carlosgj/Garage-Controller/MCAD/7527K44_300V AC-300V DC Terminal Block.SLDPRT

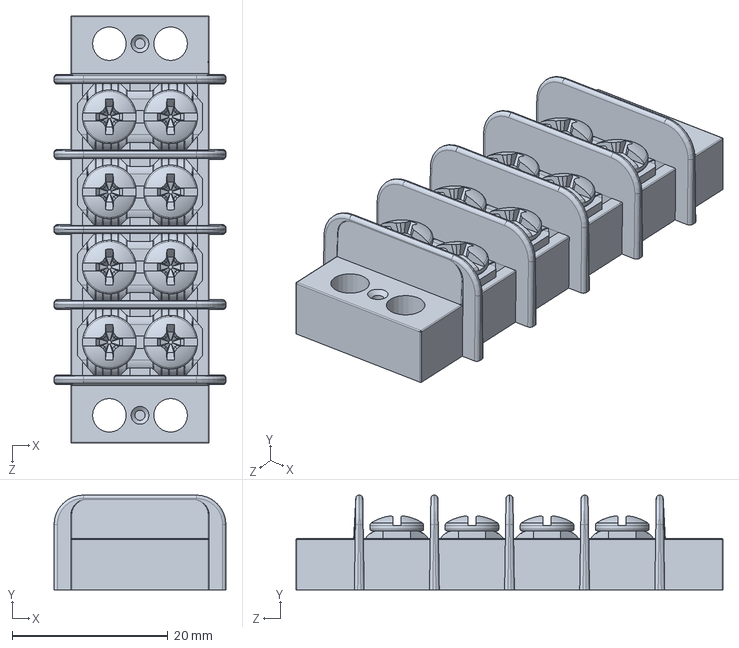
[picture p1: CAD file, 2026-06-23]
MCAD/7527K44_300V AC-300V DC Terminal Block.SLDPRT
22.1 x 12.2 x 54.9 mm
