carlosgj/Garage-Controller/MCAD/Controller.SLDASM

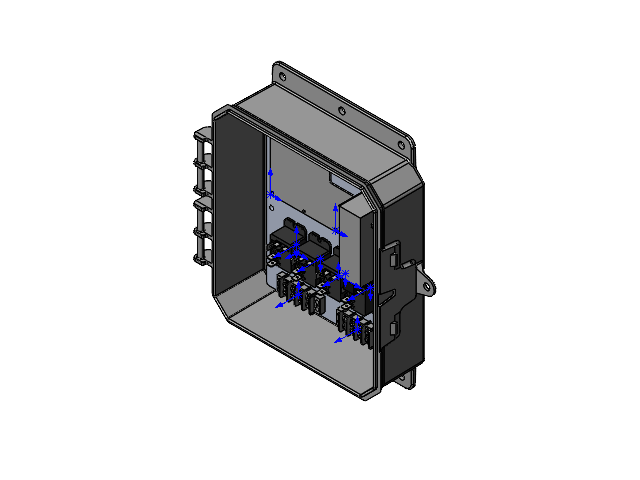
[picture p2: CAD file, 2026-06-27]
MCAD/Controller.SLDASM
Baseplate
J115F3E1CL x 4
7527K44_300V AC-300V DC Terminal Block x 2
converter_rs-25-12
PWB
P982BH
