carlosgj/Garage-Controller/MCAD/Electronics Assembly.SLDASM

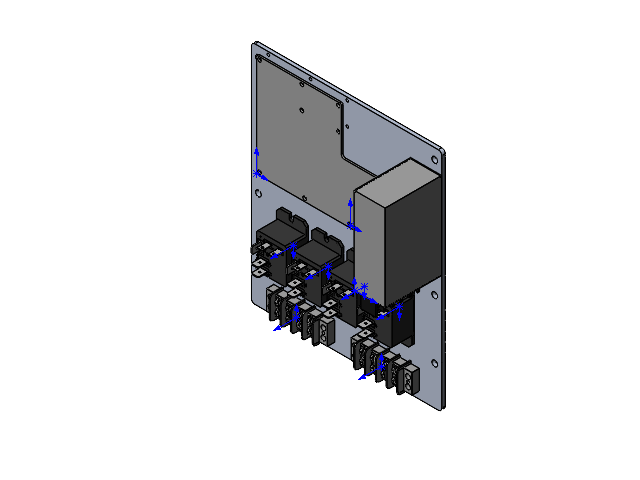
[picture p3: CAD file, 2026-06-27]
MCAD/Electronics Assembly.SLDASM
Baseplate
J115F3E1CL x 4
7527K44_300V AC-300V DC Terminal Block x 2
converter_rs-25-12
PWB
