carlosgj/Garage-Controller/MCAD/p9082.SLDASM

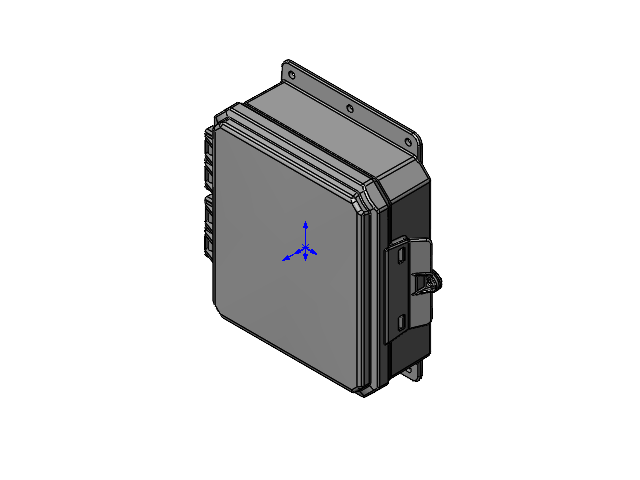
[picture p4: CAD file, 2026-06-23]
MCAD/p9082.SLDASM
P982BH
P98CHO
