carlosgj/Garage-Controller/(list of files, cad)

Other CAD files:
MCAD/Baseplate.SLDPRT
MCAD/PWB.SLDPRT
MCAD/converter_rs-25-12.SLDPRT
MCAD/J115F3E1CL.SLDPRT
MCAD/P98CHO.SLDPRT
MCAD/P982BH.SLDPRT
