carlosgj/Garage-Controller/ECAD/Sensor Board.brd

## EAGLE design ECAD/Sensor Board.brd (2026-07-01)

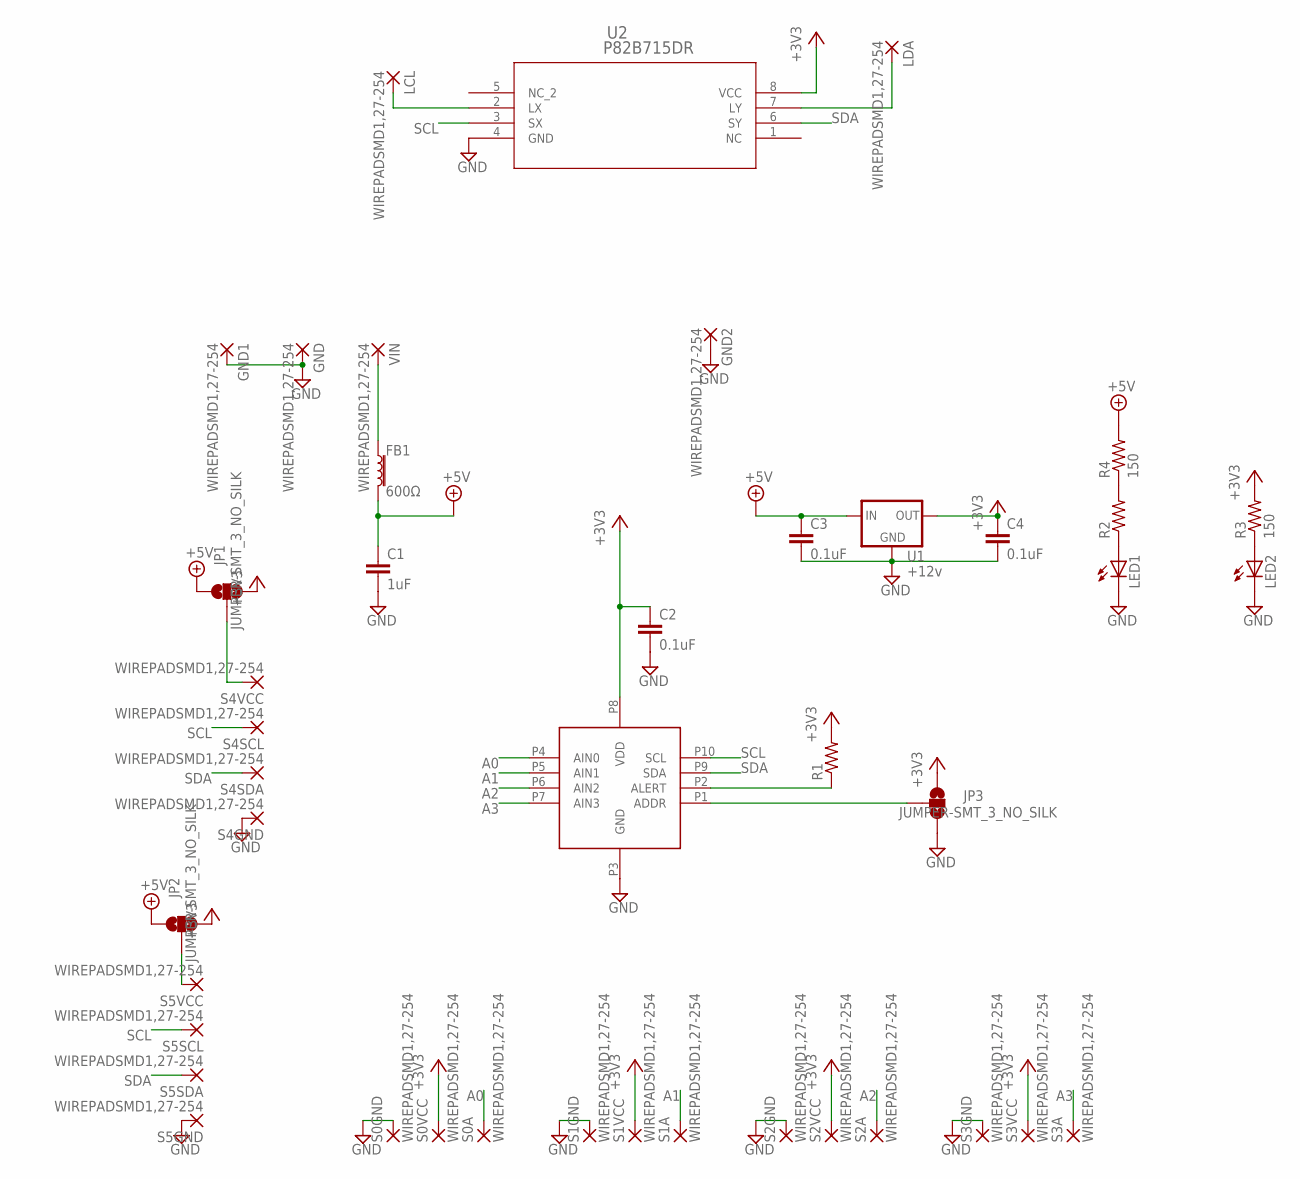
[picture p5: schematic Sensor Board.sch]

Parts:
C1: 1uF; C0805
C2, C3, C4: 0.1uF; C0805
FB1: 600Ω; 0805
GND, GND1, GND2: WIREPADSMD1,27-254; SMD1,27-2,54
JP1, JP2, JP3: JUMPER-SMT_3_NO_SILK; SMT-JUMPER_3_NO_SILK
LCL: WIREPADSMD1,27-254; SMD1,27-2,54
LDA: WIREPADSMD1,27-254; SMD1,27-2,54
LED1, LED2: LEDCHIP-LED0805; CHIP-LED0805
R1, R2: R-US_R0805; R0805
R3, R4: 150; R0805
S0A, S0GND, S0VCC, S1A, S1GND, S1VCC, S2A, S2GND, S2VCC, S3A, S3GND, S3VCC, S4GND, S4SCL, S4SDA, S4VCC, S5GND, S5SCL, S5SDA, S5VCC: WIREPADSMD1,27-254; SMD1,27-2,54
U1: +12v; TO-252
U2: P82B715DR; SO-08
U3: ADS1115; VSSOP-10
VIN: WIREPADSMD1,27-254; SMD1,27-2,54

Connections:
+3V3: C2.1, C4.1, JP1.3, JP2.3, JP3.1, R1.2, R3.2, S0VCC.1, S1VCC.1, S2VCC.1, S3VCC.1, U1.2 (OUT), U2.8 (VCC), U3.P8 (VDD)
+5V: C1.1, C3.1, FB1.2, JP1.1, JP2.1, R4.2, U1.1 (IN)
A0: S0A.1, U3.P4 (AIN0)
A1: S1A.1, U3.P5 (AIN1)
A2: S2A.1, U3.P6 (AIN2)
A3: S3A.1, U3.P7 (AIN3)
GND: C1.2, C2.2, C3.2, C4.2, GND.1, GND1.1, GND2.1, JP3.3, LED1.C, LED2.C, S0GND.1, S1GND.1, S2GND.1, S3GND.1, S4GND.1, S5GND.1, U1.3 (GND), U2.4 (GND), U3.P3 (GND)
unnamed: R1.1, U3.P2 (ALERT)
unnamed: FB1.1, VIN.1
unnamed: JP2.2, S5VCC.1
unnamed: JP3.2, U3.P1 (ADDR)
unnamed: JP1.2, S4VCC.1
unnamed: LED1.A, R2.1
unnamed: LED2.A, R3.1
unnamed: R2.2, R4.1
unnamed: LDA.1, U2.7 (LY)
unnamed: LCL.1, U2.2 (LX)
SCL: S4SCL.1, S5SCL.1, U2.3 (SX), U3.P10 (SCL)
SDA: S4SDA.1, S5SDA.1, U2.6 (SY), U3.P9 (SDA)

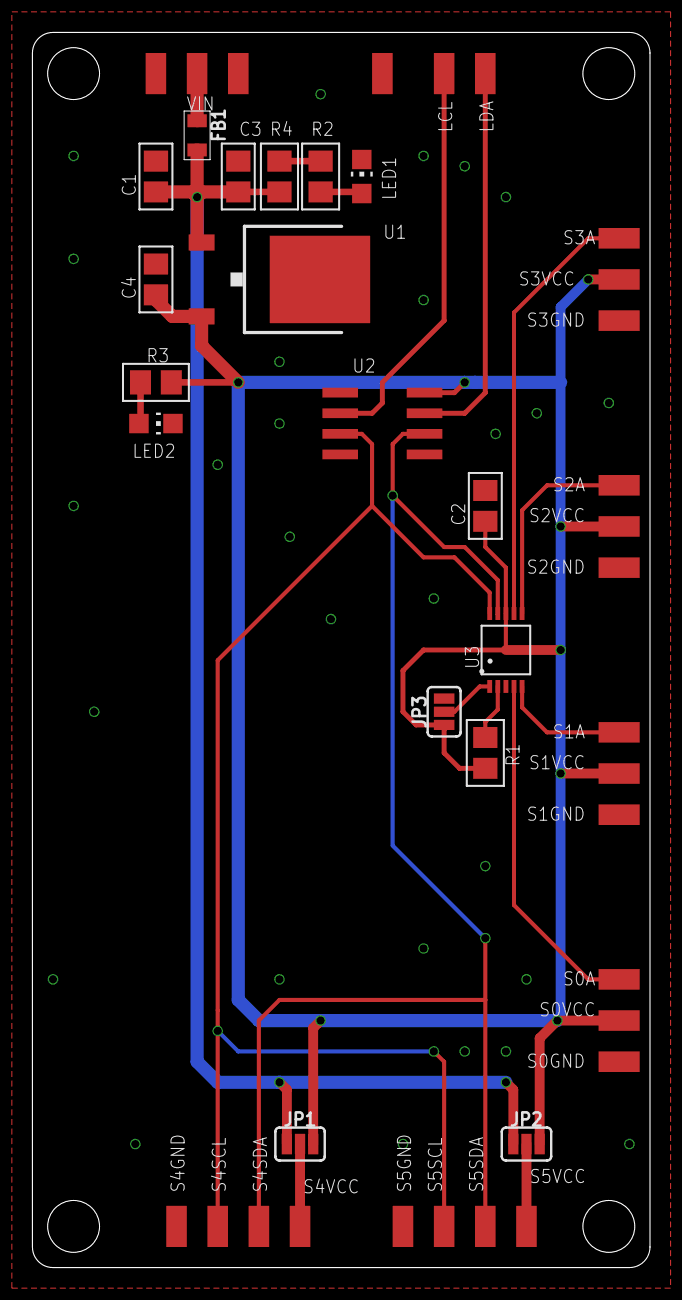
[picture p6: board Sensor Board.brd from above]

Board: 2 copper layers, 38.1 x 76.2 mm, 43 parts (0 on the bottom side), 19 nets.
