carlosgj/Garage-Controller/ECAD/Garage_Controller.brd

## EAGLE design ECAD/Garage_Controller.brd (2026-07-01)

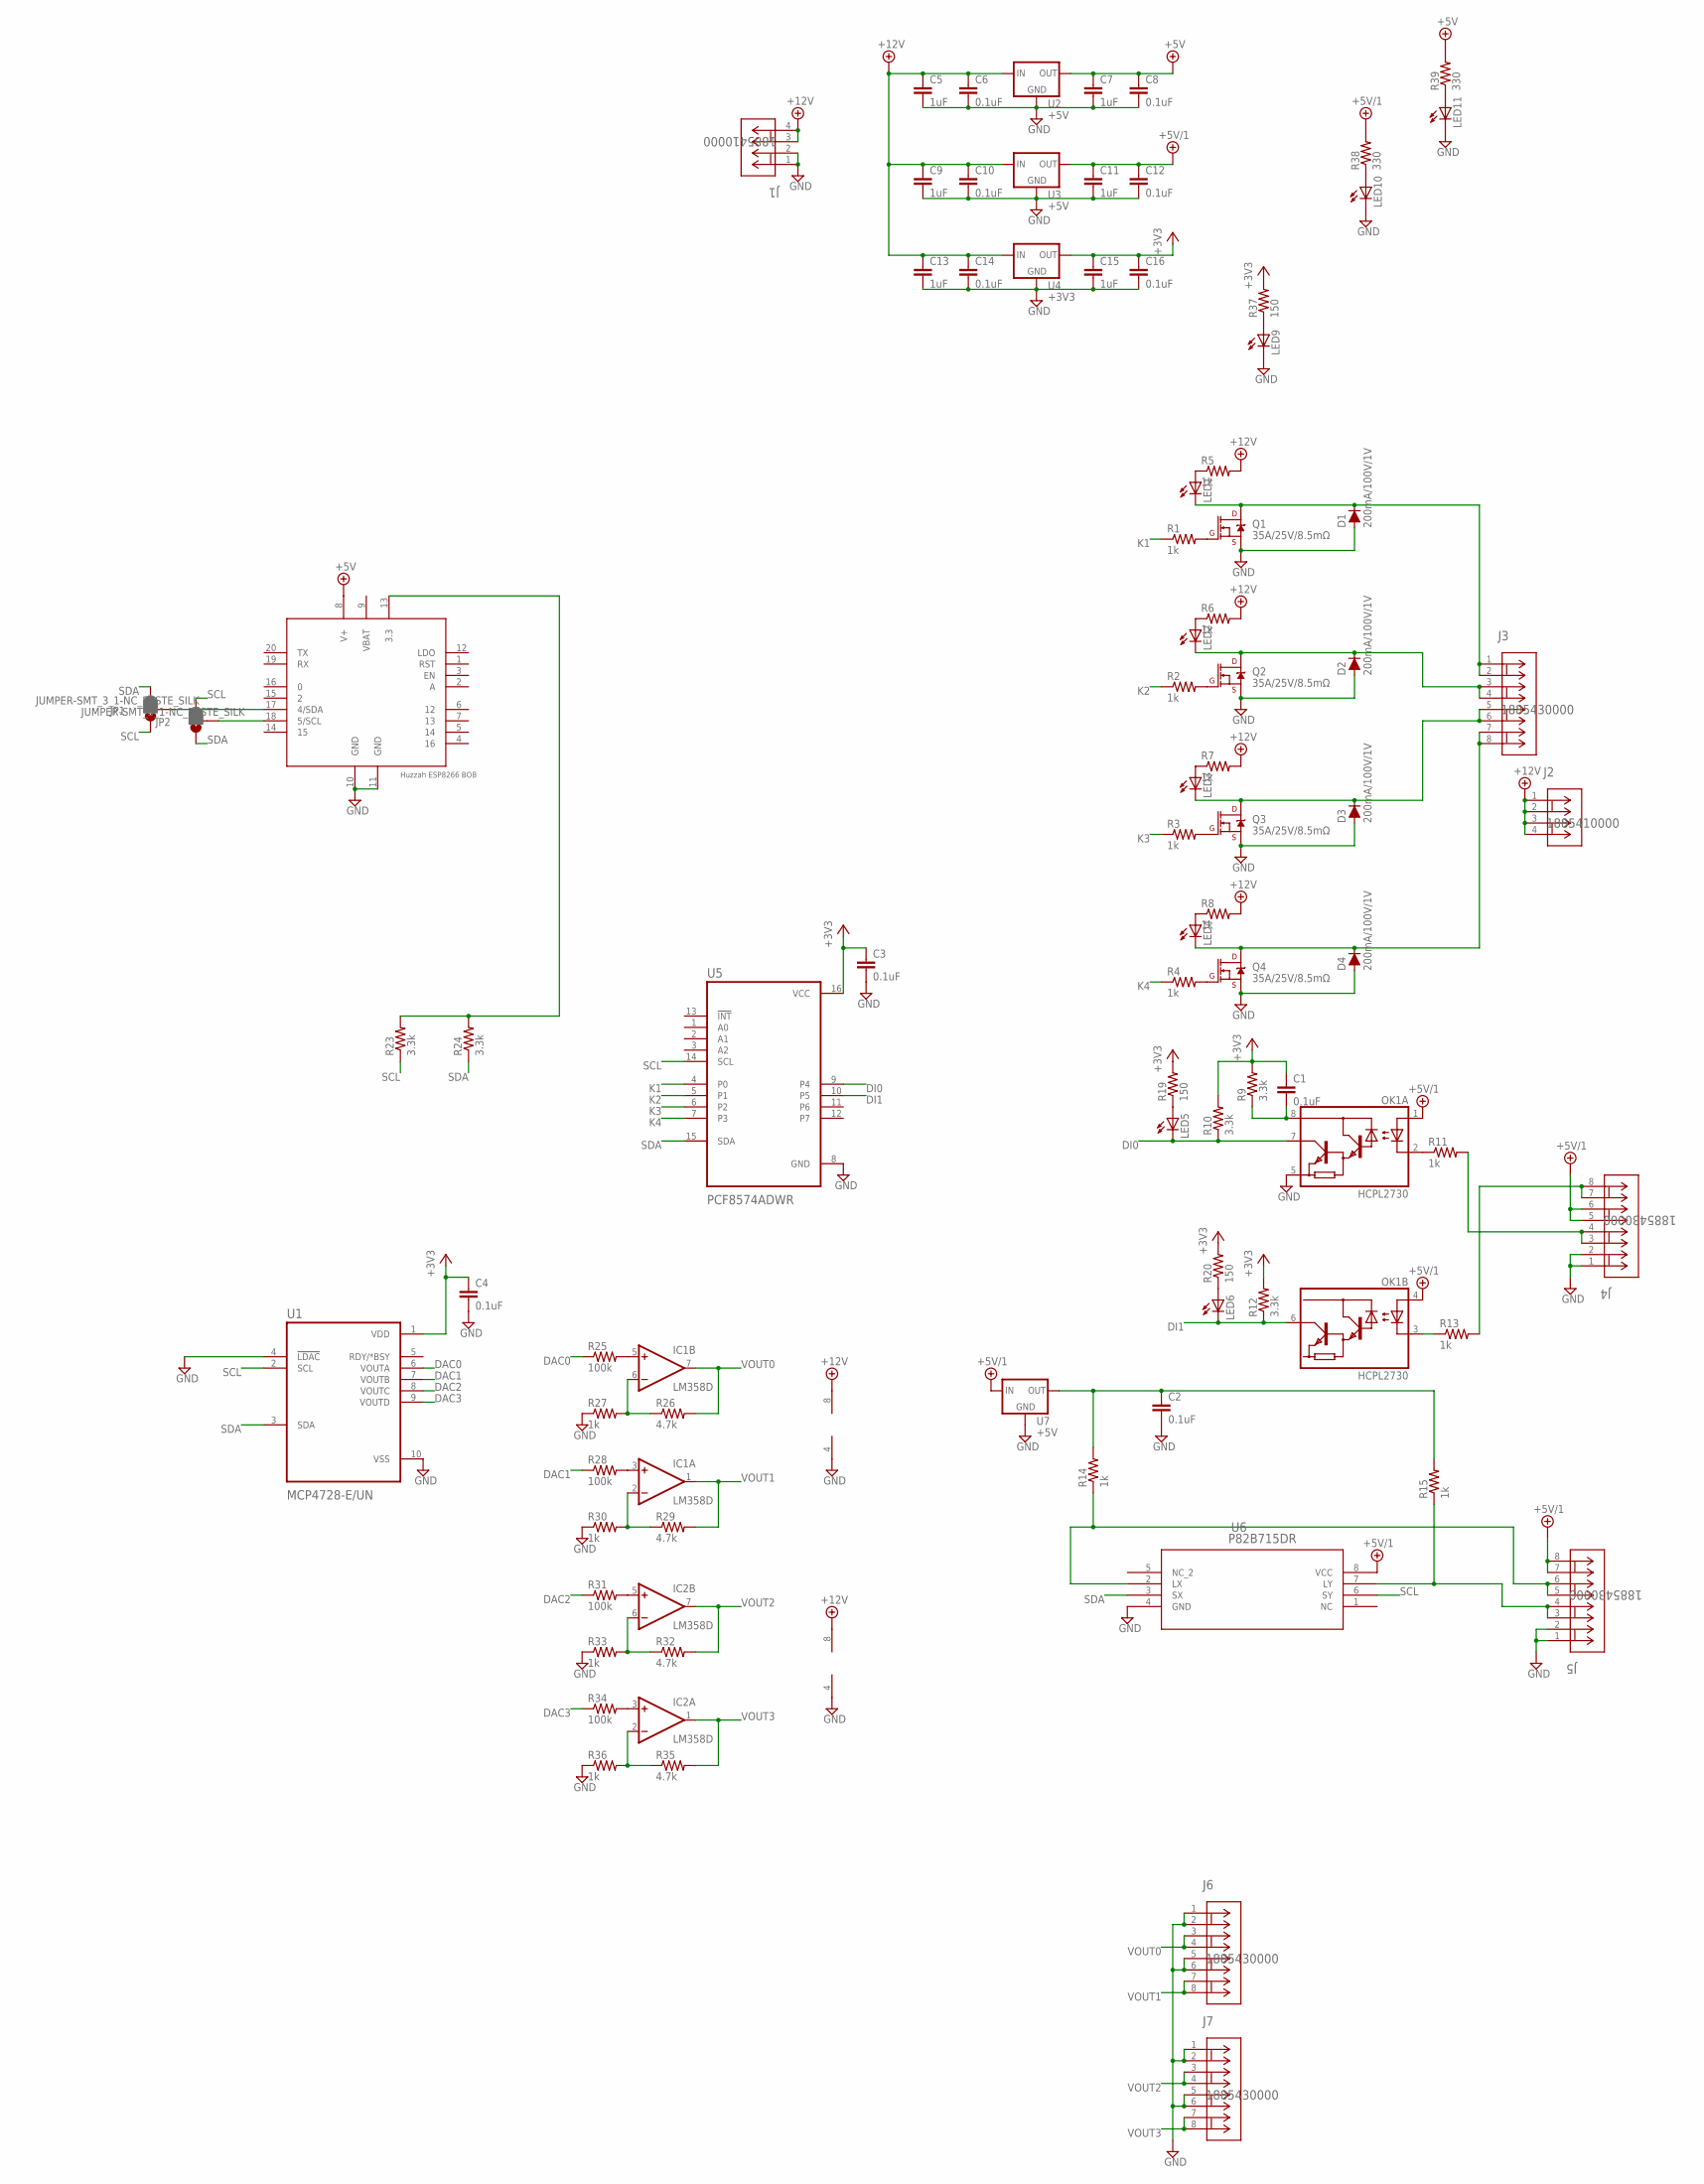
[picture p7: schematic Garage_Controller.sch]

Parts:
C1, C2, C3, C4, C6, C8, C10, C12, C14, C16: 0.1uF; C0805
C5, C7, C9, C11, C13, C15: 1uF; C0805
D1, D2, D3, D4: 200mA/100V/1V; DIODE-1N4148
IC1, IC2: LM358D; SO08
J1, J2: 1885410000; CONN_1885410000_WED
J3, J4, J5, J6, J7: 1885430000; CONN_1885430000_WED
JP1, JP2: JUMPER-SMT_3_1-NC_PASTE_SILK; SMT-JUMPER_3_1-NC_PASTE_SILK
LED1, LED2, LED3, LED4, LED5, LED6, LED9, LED10, LED11: LEDCHIP-LED0805; CHIP-LED0805
OK1: HCPL2730; DIL08
Q1, Q2, Q3, Q4: 35A/25V/8.5mΩ; TO-252/DPAK
R1, R2, R3, R4, R5, R6, R7, R8, R11, R13, R14, R15, R27, R30, R33, R36: 1k; R0805
R9, R10, R12, R23, R24: 3.3k; R0805
R19, R20, R37: 150; R0805
R25, R28, R31, R34: 100k; R0805
R26, R29, R32, R35: 4.7k; R0805
R38, R39: 330; R0805
U1: MCP4728-E/UN; SOP50P490X110-10N
U2, U3, U7: +5V; TO-252
U4: +3V3; TO-252
U5: PCF8574ADWR; SOIC127P1030X265-16N
U6: P82B715DR; SO-08
U$2: HUZZAH_ESP8266_BREAKOUT

Connections:
+3V3: C1.1, C3.1, C4.1, C15.1, C16.1, R9.2, R10.2, R12.2, R19.2, R20.2, R37.2, U1.1 (VDD), U4.2 (OUT), U5.16 (VCC)
+5V: C7.1, C8.1, R39.2, U2.2 (OUT), U$2.8 (V+)
+5V/1: C11.1, C12.1, J4.5, J4.6, J5.7, J5.8, OK1.1 (A1), OK1.4 (A2), R38.2, U3.2 (OUT), U6.8 (VCC), U7.1 (IN)
+12V: C5.1, C6.1, C9.1, C10.1, C13.1, C14.1, IC1.8 (V+), IC2.8 (V+), J1.3, J1.4, J2.1, J2.2, J2.3, J2.4, R5.2, R6.2, R7.2, R8.2, U2.1 (IN), U3.1 (IN), U4.1 (IN)
DAC0: R25.1, U1.6 (VOUTA)
DAC1: R28.1, U1.7 (VOUTB)
DAC2: R31.1, U1.8 (VOUTC)
DAC3: R34.1, U1.9 (VOUTD)
DI0: LED5.C, OK1.7 (VO1), R10.1, U5.9 (P4)
DI1: LED6.C, OK1.6 (VO2), R12.1, U5.10 (P5)
GND: C2.2, C3.2, C4.2, C5.2, C6.2, C7.2, C8.2, C9.2, C10.2, C11.2, C12.2, C13.2, C14.2, C15.2, C16.2, D1.A, D2.A, D3.A, D4.A, IC1.4 (V-), IC2.4 (V-), J1.1, J1.2, J4.1, J4.2, J5.1, J5.2, J6.1, J6.2, J6.5, J6.6, J7.1, J7.2, J7.5, J7.6, LED9.C, LED10.C, LED11.C, OK1.5 (GND), Q1.3 (S), Q2.3 (S), Q3.3 (S), Q4.3 (S), R27.1, R30.1, R33.1, R36.1, U1.4 (!LDAC), U1.10 (VSS), U2.3 (GND), U3.3 (GND), U4.3 (GND), U5.8 (GND), U6.4 (GND), U7.3 (GND), U$2.10 (GND), U$2.11 (GND)
K1: R1.1, U5.4 (P0)
K2: R2.1, U5.5 (P1)
K3: R3.1, U5.6 (P2)
K4: R4.1, U5.7 (P3)
unnamed: D1.C, J3.1, J3.2, LED1.C, Q1.2 (D)
unnamed: Q1.1 (G), R1.2
unnamed: D2.C, J3.3, J3.4, LED2.C, Q2.2 (D)
unnamed: Q2.1 (G), R2.2
unnamed: D3.C, J3.5, J3.6, LED3.C, Q3.2 (D)
unnamed: Q3.1 (G), R3.2
unnamed: D4.C, J3.7, J3.8, LED4.C, Q4.2 (D)
unnamed: Q4.1 (G), R4.2
unnamed: LED1.A, R5.1
unnamed: IC1.5 (+IN), R25.2
unnamed: LED2.A, R6.1
unnamed: LED3.A, R7.1
unnamed: J4.7, J4.8, R13.2
unnamed: LED4.A, R8.1
unnamed: C1.2, OK1.8 (VCC), R9.1
unnamed: IC1.6 (-IN), R26.1, R27.2
unnamed: OK1.2 (C1), R11.1
unnamed: IC1.3 (+IN), R28.2
unnamed: J4.3, J4.4, R11.2
unnamed: J5.5, J5.6, R14.1, U6.2 (LX)
unnamed: C2.1, R14.2, R15.2, U7.2 (OUT)
unnamed: IC1.2 (-IN), R29.1, R30.2
unnamed: J5.3, J5.4, R15.1, U6.7 (LY)
unnamed: OK1.3 (C2), R13.1
unnamed: LED5.A, R19.1
unnamed: LED6.A, R20.1
unnamed: IC2.5 (+IN), R31.2
unnamed: IC2.6 (-IN), R32.1, R33.2
unnamed: IC2.2 (-IN), R35.1, R36.2
unnamed: IC2.3 (+IN), R34.2
unnamed: R23.2, R24.2, U$2.13 (3.3)
unnamed: LED9.A, R37.1
unnamed: LED10.A, R38.1
unnamed: LED11.A, R39.1
unnamed: JP2.2, U$2.18 (5/SCL)
unnamed: JP1.2, U$2.17 (4/SDA)
SCL: JP1.1, JP2.3, R23.1, U1.2 (SCL), U5.14 (SCL), U6.6 (SY)
SDA: JP1.3, JP2.1, R24.1, U1.3 (SDA), U5.15 (SDA), U6.3 (SX)
VBAT: U$2.9 (VBAT)
VOUT0: IC1.7 (OUT), J6.3, J6.4, R26.2
VOUT1: IC1.1 (OUT), J6.7, J6.8, R29.2
VOUT2: IC2.7 (OUT), J7.3, J7.4, R32.2
VOUT3: IC2.1 (OUT), J7.7, J7.8, R35.2

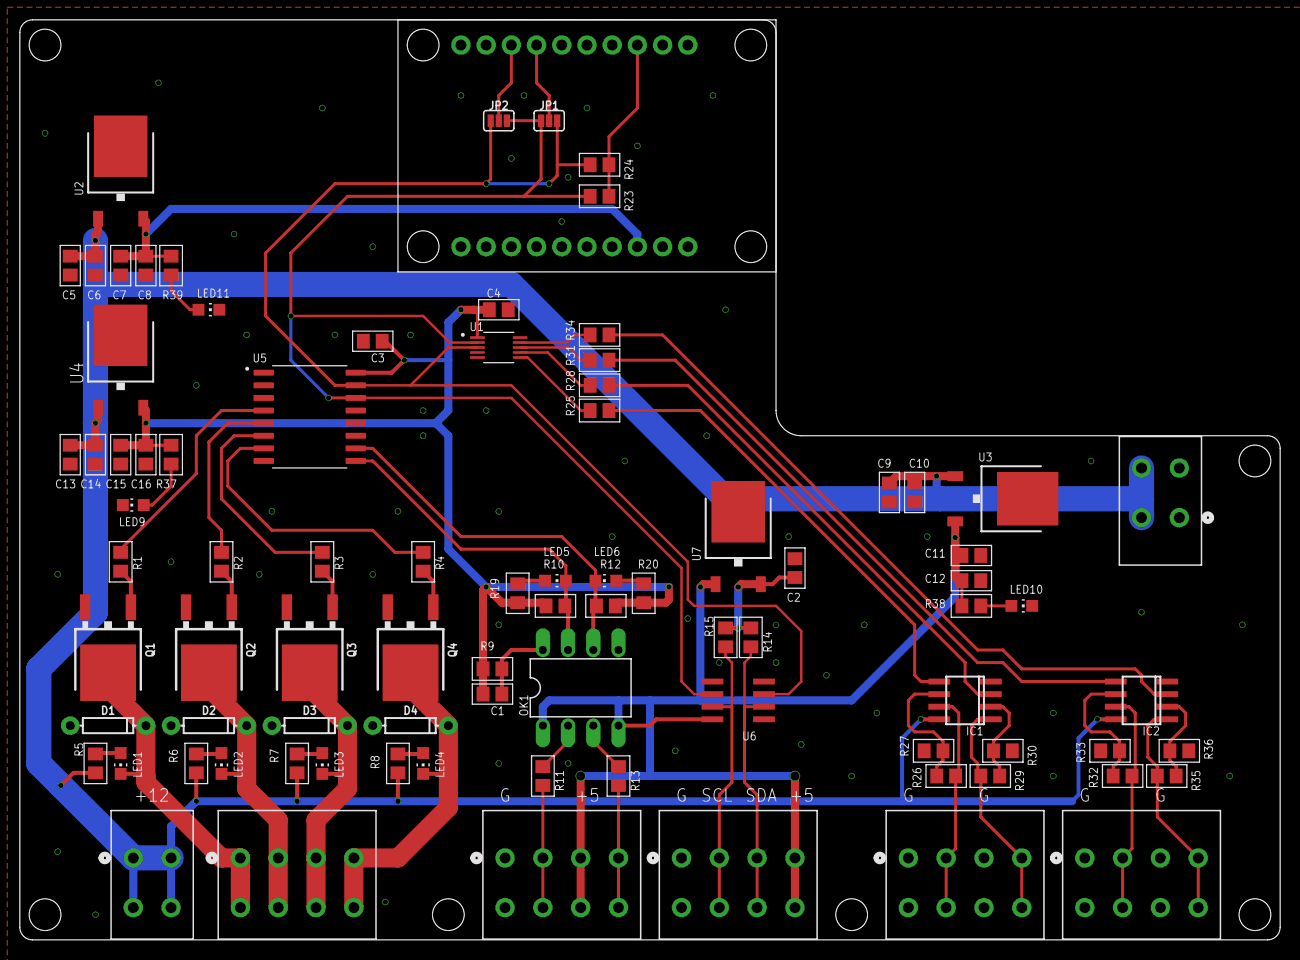
[picture p8: board Garage_Controller.brd from above]

Board: 2 copper layers, 127.0 x 92.7 mm, 87 parts (0 on the bottom side), 57 nets.
