carlosgj/Garage-Controller/(commit log)

2026-06-24 Providing +5V at DI connector
    [Garage_Controller.brd, Garage_Controller.sch]
2026-06-24 First work on ESPHome config
    [garagecontroller.yaml]
2026-06-24 Switching to Huzzah ESP8266 breakout
    [Baseplate.SLDPRT, Controller.SLDASM, Electronics Assembly.SLDASM, Garage_Controller.brd, Garage_Controller.sch, PWB.SLDPRT]
2026-06-27 Adding sensor board
    [Controller.SLDASM, Electronics Assembly.SLDASM, Sensor Board.brd, Sensor Board.sch]
2026-07-01 Ordered PWBs
    [Garage_Controller.brd, Garage_Controller.sch, Garage_Controller_top_bom.csv, Sensor Board.brd, Sensor Board.sch, Sensor Board_top_bom.csv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]
